LeoUpperThrower4/Projeto-TCC/README.md

# Escâner Tridimensional de Pequenos Objetos

<!---Esses são exemplos. Veja https://shields.io para outras pessoas ou para personalizar este conjunto de escudos. Você pode querer incluir dependências, status do projeto e informações de licença aqui--->







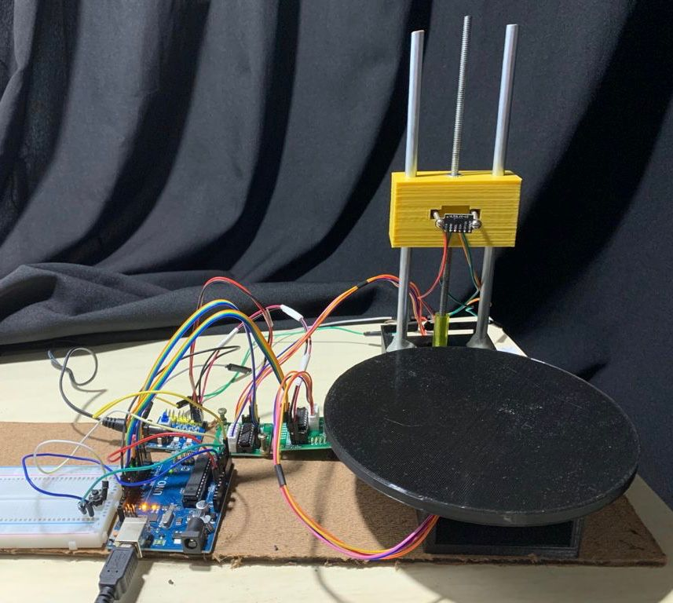
[picture p1: protótipo.jpeg]
Protótipo do projeto construído


## 🔖 Artigo

No [artigo](Artigo_TCC.pdf) é possível encontrar todo projeto escrito detalhadamente com fotos dos resultados e testes.

## 🚀 Instalando o projeto

Para instalar o projeto, siga estas etapas:

- Instale a IDE do [Arduino](https://www.arduino.cc/en/software#:~:text=GETTING%20STARTED-,Downloads,-Arduino%20IDE%201.8.15). No projeto foi utilizada a versão 1.8.15

- Instale o [Python](https://www.python.org/downloads/). No projeto foi utilizada a versão 3.9.0

- Clone o projeto:

```bash
$ git clone https://github.com/LeoUpperThrower4/Projeto-TCC.git

$ cd Projeto-TCC
```

## ☕ Usando o projeto

Para usar o projeto, siga estes passos:

- Abra o arquivo ```sensor_VL53L.ino``` na IDE do Arduino
- Envie-o para o microcontrolador
- Através dos dois botões, ajuste o ponto inicial do sensor
- Abra e inicie o arquivo ```leitor.py```
- Clique no botão principal para iniciar o processo de modelagem

## 📫 Contribuindo para o projeto

<!---Se o seu README for longo ou se você tiver algum processo ou etapas específicas que deseja que os contribuidores sigam, considere a criação de um arquivo CONTRIBUTING.md separado--->

Para contribuir com o projeto, siga estas etapas:

1. Bifurque este repositório.
2. Crie um branch: `git checkout -b <nome_branch> origin/main`.
3. Faça suas alterações e confirme-as: `git commit -m '<mensagem_commit>'`
4. Envie para o branch original: `git push origin <nome_branch>`
5. Crie a solicitação de pull para a branch main.

Como alternativa, consulte a documentação do GitHub em [como criar uma solicitação pull](https://help.github.com/en/github/collaborating-with-issues-and-pull-requests/creating-a-pull-request).

## 🤝 Colaboradores

<table>
  <tr>
    <td align="center">
      <a href="https://github.com/LeoUpperThrower4">
        Foto do Leonardo Silva no GitHub<br>
        <sub>
          <b>Leonardo Silva</b>
        </sub>
      </a>
    </td>
    <td align="center">
      <a href="#">
        Foto do Gabriel Teixeira<br>
        <sub>
          <b>Gabriel Teixeira</b>
        </sub>
      </a>
    </td>
    <td align="center">
      <a href="https://github.com/PedroScheunemann">
        Foto do Pedro Scheunemann<br>
        <sub>
          <b>Pedro Scheunemann</b>
        </sub>
      </a>
    </td>
  </tr>
</table>

## 😄 Contribua<br>

Sinta-se à vontade para contribuir!

## 📝 Licença

Esse projeto está sob a licença MIT. Veja o arquivo [LICENSE](LICENSE.md) para mais detalhes.

[⬆ Voltar ao topo](#nome-do-projeto)<br>
